MOSH-Insa-Toulouse/2022_2023_4G_Kerleau_Cassagne/Images/courbe_déformation.jpg

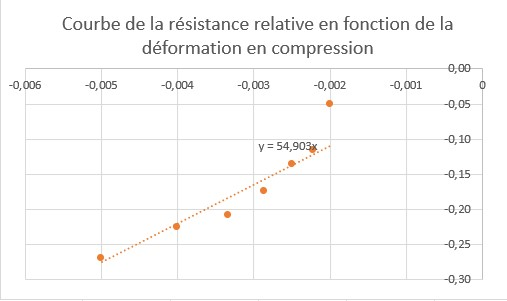
Images/courbe_déformation.jpg
