MOSH-Insa-Toulouse/2022_2023_4G_Kerleau_Cassagne/Images/courbe_tension.jpg

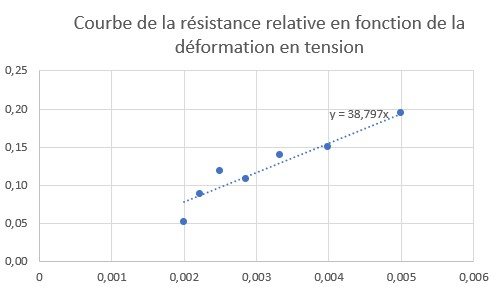
Images/courbe_tension.jpg
