MOSH-Insa-Toulouse/2022_2023_4G_Kerleau_Cassagne/Interface Python/graphe.py

#Si le module PySerial n'est pas installé: pip install --user PySerial

#importation des modules
import serial
import serial.tools.list_ports # pour la communication avec le port série
import matplotlib.pyplot as plt  # pour le tracé de graphe
from matplotlib import animation # pour la figure animée
import time # gestion du temps

#initialisation des listes
liste_temps_mesure = [] # liste pour stocker le temps "brut"
liste_temps = [] # liste pour stocker les valeurs de temps en partant de t=0
liste_data = [] # liste pour stocker les valeurs de distance

t_acquisition = 30 #temps d'acquisition total
datamax = 200 # valeur maximum des ordonnées
numero_colonne_data = 0 #correspond à la position des data dans la chaîne envoyée par l'Arduino

# Fonction pour la récupération des données série venant de la carte Arduino
def recup_port_Arduino() :
    ports = list(serial.tools.list_ports.comports())
    for p in ports:
        if 'Arduino' in p.description or 'USB-SERIAL CH340' in p.description :
            mData = serial.Serial(p.device,9600)
    print(mData.is_open) # Affiche et vérifie que le port est ouvert
    print(mData.name) # Affiche le nom du port 
    return mData

Data = recup_port_Arduino() #récupération des données

#pour le graphe en temps réel
def animate(i):
    line1 = Data.readline()
    listeDonnees = line1.strip()
    listeDonnees = line1.split()
    tempsreel = 0
    if len(listeDonnees) != 0 and (tempsreel <= t_acquisition) :
        data = float(listeDonnees[numero_colonne_data].decode())
        tempsmes = time.time()
        liste_temps_mesure.append(tempsmes)
        tempsreel = tempsmes - liste_temps_mesure[0]

        liste_data.append(data)
        liste_temps.append(tempsreel)
        print("d = %f"%(data), " mm")
        print("temps mesuré = %f"%(tempsmes), " s")
        print("temps réel= %f"%(tempsreel), " s")
        line.set_data(liste_temps, liste_data)

        # Condition de sortie
        if tempsreel >= t_acquisition :
            print("acq terminée")
            ani.event_source.stop()  # Arrête l'animation

        counter_text.set_text('Data: {}'.format(data))

   
# Création figure
fig=plt.figure()
line, = plt.plot([],[])
plt.xlim(0, t_acquisition)
plt.ylim(0,datamax)
plt.xlabel('temps (s)')
plt.ylabel('Résistance (MOhm)')
plt.grid()

counter_text = plt.text(0.1, 0.9, '', transform=fig.transFigure)


#Animation

ani = animation.FuncAnimation(fig, animate, frames=t_acquisition*50, interval=20, repeat=False)
plt.show()
plt.close(fig)
Data.close() # pour arrêter la lecture des données série
