MOSH-Insa-Toulouse/2022_2023_4G_Kerleau_Cassagne/(commit log)

2023-05-16 Première version de la datasheet
2023-05-16 Code Arduino
2023-05-16 Données de test du banc de test et de l'écocup
    [data capteur.xlsx]
2023-05-30 Données Datasheet V2
    [data capteur.xlsx]
2023-05-30 Ajout des images au ReadMe
2023-05-30 Ajout des images
2023-05-30 Ajout de l'analyse sur LTspice
2023-05-30 Ajout des images sur le readme
2023-05-30 Readme sans la partie sur Python
2023-05-30 Données capteur modifiées
    [data capteur.xlsx]
2023-05-30 Datasheet de notre capteur
